ayoolaeni/safehomeedgeai/(commit log)

2026-10-05 Initial release of SafeHome Edge AI
    ESP32 smart lamp controller with motion and light sensing, safety
    mechanisms, graduation levels S1-S5, Wi-Fi setup hotspot, Flutter phone
    app with hold-to-speak voice control, Mosquitto broker config, client
    setup guide, and a browser-based firmware install page.
    [all_sensors_test.ino, broker_settings.cpp, broker_settings.h, config.h, decision_engine.cpp, decision_engine.h]
2026-10-25 Whole-home Thriftogentic Home Digital Twin (v2)
    Extend SafeHome from one lamp to the whole house, following the AHDT,
    THDT subsystem and Lagos Thriftonomous AI Homes specifications.
    - server/: home server with the AHDT orchestrator and six subsystem twins
    (Energy, Fire & Safety, Water, Climate, Access & Security, Resident), a
    Thriftogentic AI guardrail layer, per-twin graduation from THRIFTOGENTIC
    to THRIFTONOMOUS with household sign-off, cross-domain emergency
    directives, a hash-chained audit log, optional local SLM via Ollama, and
    stubbed cloud LLM / 4G-5G escalation. 18 end-to-end tests.
    - app/: redesigned Material 3 whole-home dashboard (Home, Rooms floor plan,
    Twins, Assist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
2026-10-25 Show all icons and label the top buttons
    Release builds trimmed the Material icon font (4 KB on Windows), so most
    icons rendered blank. Build with --no-tree-shake-icons, and give the
    Demo and Connect buttons text labels.
2026-10-25 Redesign the ESP32 lamp screen
    Glowing lamp card with On/Off buttons, stat tiles for light, motion and
    light level, a gradient hold-to-speak button, a segmented mode switch,
    and grouped connection and activity cards. Behaviour is unchanged; a
    render test now taps Turn on and checks the command is sent.
